camptwright/capstone-pcb-design/extra/extra/Screenshot 2026-03-03 145133.png

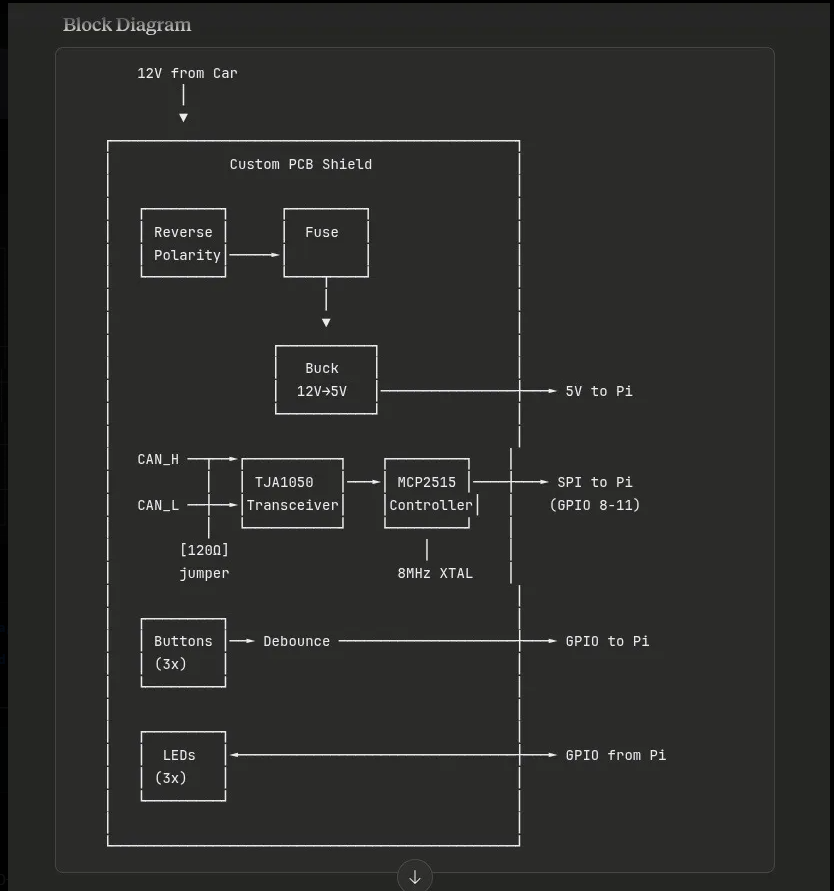
extra/extra/Screenshot 2026-03-03 145133.png
