camptwright/capstone-pcb-design/extra/extra/unnamed (1).png

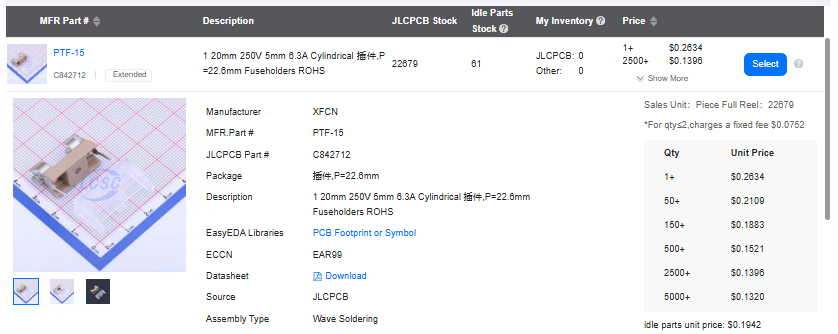
extra/extra/unnamed (1).png
