camptwright/capstone-pcb-design/extra/extra/unnamed (2).png

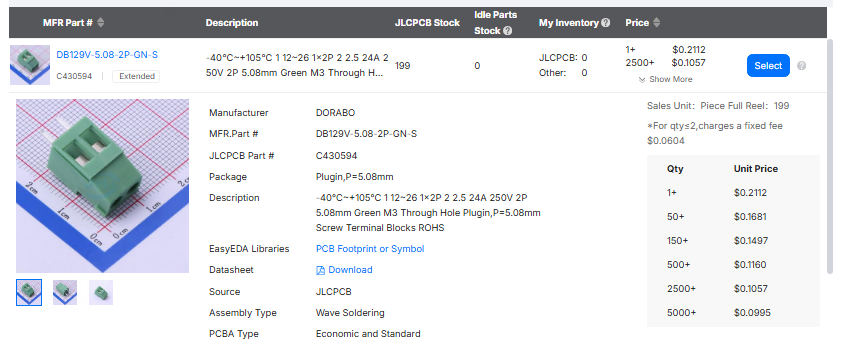
extra/extra/unnamed (2).png
