camptwright/capstone-pcb-design/extra/extra/unnamed (3).png

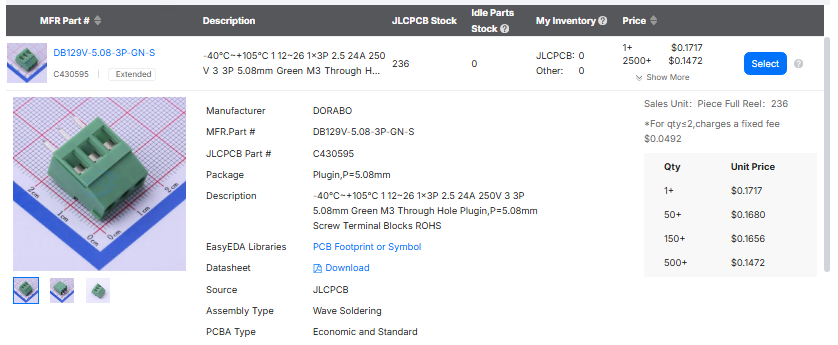
extra/extra/unnamed (3).png
