camptwright/capstone-pcb-design/extra/extra/unnamed.png

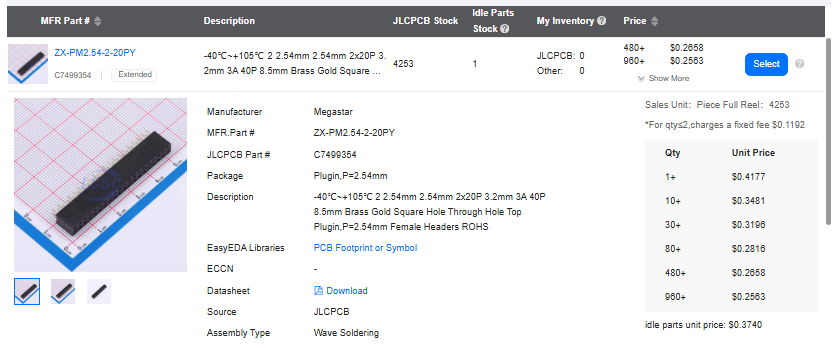
extra/extra/unnamed.png
