camptwright/capstone-pcb-design/extra/extra/T-I4W645599A-1sets-fsae_daughterboard_BOM_PCBWay(2026-03-10).xls

PCBWay Bom Quotation, Product No.:T-I4W645599A
Item # | *Designator | *Qty | *Mfg Part # | Description / Value | *Package/Footprint | *Unit Price(1 set) | *Total | *Delivery Time | *Actual Purchase Mfg Part # | *PCBWay Note | Customer Reply | PCBWay Update
1 | SW1 SW2 SW3 | 3 | TS-06104 | 6mm Tactile Push Button | SW_PUSH_6mm_H5mm |  |  |  |  | [It's out of stock. Please recommend substitutes or you can supply this part to us.] | Please use an equivalent 6 mm × 6 mm through‑hole tactile push button with the same 4‑pin 2.54 mm × 4.5 mm footprint and ~5 mm height as TS‑06104. Preferred: Schurter 1301.9301 (DigiKey 486‑3457‑ND) or any fully compatible 6×6×5 mm THT tact switch. If no exact substitute is available, please leave SW1, SW2, SW3 unmounted (DNP) and I will install them myself.
2 | LED3 | 1 | LED 5mm Green | Green LED 5mm | LED_D5.0mm |  |  |  |  | Please provide exact part number or component URL | Please use Kingbright WP7113SGD – Green 5 mm diffused LED (DigiKey 754‑1735‑ND). Datasheet / URL: https://www.kingbrightusa.com/images/catalog/spec/WP7113SGD.pdf
3 | LED4 | 1 | LED 5mm Blue | Blue LED 5mm | LED_D5.0mm |  |  |  |  | Please provide exact part number or component URL | Please use Everlight EALP05RDGBA0(DGK) – Blue 5 mm LED (DigiKey 1080‑EALP05RDGBA0(DGK)‑ND)
4 | LED5 | 1 | LED 5mm Red | Red LED 5mm | LED_D5.0mm |  |  |  |  | Please provide exact part number or component URL | Please use Kingbright WP7113SRD/J4 – Red 5 mm diffused LED (DigiKey 754‑2139‑ND). Datasheet / URL: https://www.kingbrightusa.com/images/catalog/spec/WP7113SRD-J4.pdf
5 | R5 R6 R7 | 3 | RC0805JR-07330RL | 330R 0805 | R_0805_2012Metric | $0.113 | $0.339
6 | R8 R9 R10 | 3 | RC0805JR-0710KL | 10K 0805 | R_0805_2012Metric | $0.113 | $0.339
7 | C12 C13 C14 | 3 | CL21B104KBCNNNC | 100nF 16V X7R 0805 | C_0805_2012Metric | $0.193 | $0.579 |  |  | The correct voltage for the listed Part Number [CL21B104KBCNNNC] is indeed [50V], not [16V].Please confirm. | Confirmed: 50V is acceptable
8 | J6 | 1 | Molex 43045-0812 | Molex Micro-Fit 3.0 2x4 | Molex_Micro-Fit_3.0_43045-0812_2x04_P3.00mm_Vertical | $0.965 | $0.965 |  | 43045-0812
 |  |  |  |  |  | Component Cost | $2.22
 |  |  |  |  |  | Assembly Cost | $88.00
 |  |  |  |  |  | PCB Cost | $5.00
 |  |  |  |  |  | V0 Member 0% off | $0.00
 |  |  |  |  |  | All Total 1 Sets | $95.22
客户相同型号的位号分开了，这次给客户合并了，麻烦客户下次提供相同型号的位号放在一起的bom
