camptwright/capstone-pcb-design/extra/extra/updated  quotation-T-6P2W645599A-1sets-fsae_pcb_BOM_PCBWay(2026-03-11).xls

PCBWay Bom Quotation, Product No.:T-6P2W645599A
Item # | *Designator | *Qty | Manufacturer | *Mfg Part # | Description / Value | *Package/Footprint | *Unit Price(1 set) | *Total | *Delivery Time | *Actual Purchase Mfg Part # | *PCBWay Note | Customer Reply | PCBWay Update
1 | R_FB1 | 1 |  | RC0805FR-07100KL | 100K 1% 0805 | R_0805_2012Metric | $0.079 | $0.079
2 | R_FB2 | 1 |  | RC0805FR-0719K1L | 19.1K 1% 0805 | R_0805_2012Metric | $0.344 | $0.344 | 7-10 Workdays
3 | R1 R2 | 2 |  | RC0805JR-07330RL | 330R 0805 | R_0805_2012Metric | $0.162 | $0.324
4 | R3 | 1 |  | RC0805JR-07120RL | 120R 0805 | R_0805_2012Metric | $0.309 | $0.309
5 | R4 | 1 |  | RC0805JR-0710KL | 10K 0805 | R_0805_2012Metric | $0.309 | $0.309
6 | C1 C2 | 2 |  | 0805CG220J500NT | 22pF 50V C0G 0805 | C_0805_2012Metric | $0.277 | $0.554
7 | C3 C4 C5 C6 C9 C10 C11 C12 | 8 |  | CL21B104KBCNNNC | 100nF 16V X7R 0805 | C_0805_2012Metric | $0.088 | $0.704 |  |  | CL21B104KBCNNNC 50V
8 | C13 C14 | 2 |  | CL21A106KAYNNNE | 10uF 16V X5R 0805 | C_0805_2012Metric | $0.578 | $1.156 |  |  | CL21A106KAYNNNE 25V
9 | C21 | 1 |  | CL21B103KBANNNC | 10nF 50V X7R 0805 | C_0805_2012Metric | $0.529 | $0.529
10 | C7 | 1 |  | CL32A226MAJNNNE | 22uF 25V X5R 1210 | C_1210_3225Metric | $3.881 | $3.881
11 | C8 | 1 |  | CL32A226MOJNNNE | 22uF 10V X5R 1210 | C_1210_3225Metric | $3.780 | $3.780 |  |  | CL32A226MOJNNNE 16V
12 | U1 | 1 |  | MCP2515-I/SO | MCP2515-I/SO | SOIC-18W_7.5x11.6mm_P1.27mm | $1.912 | $1.912
13 | U2 | 1 |  | SN65HVD230DR | SN65HVD230DR | SOIC-8_3.9x4.9mm_P1.27mm | $1.260 | $1.260 |  |  | SN65HVD230DR brand：TI，package：SOIC-8
14 | U3 | 1 |  | MP1584EN-LF-Z | MP1584EN-LF-Z | SOIC-8-1EP_3.9x4.9mm_P1.27mm_EP2.29x3mm | $0.769 | $0.769
15 | D1 D2 | 2 |  | SS34 | SS34 Schottky SMA | D_SMA | $0.055 | $0.110 |  |  | SS34 brand：BLUE ROCKET，package：SMA
16 | L1 | 1 | Bourns | SWPA3225S330MT | 33uH 3A 1210 | L_1210_3225Metric | $1.922 | $1.922 |  | SRR1260-330M
17 | Y1 | 1 | Abracon | HC49-4H 8MHz 20pF | 8MHz HC49/U Crystal | Crystal_HC49-4H_Vertical | $0.503 | $0.503 |  | ABL-8.000MHZ-B2
18 | LED1 | 1 | Kingbright | LED 3mm Green | Green LED 3mm | LED_D3.0mm | $1.845 | $1.845 | 7-10 Workdays | WP710A10LZGCK
19 | LED2 | 1 | Kingbright | LED 3mm Blue | Blue LED 3mm | LED_D3.0mm | $1.627 | $1.627 | 7-10 Workdays | WP710A10LVBC/D
20 | F1 | 1 |  | Littelfuse 0215003.MXP + 01110008Z | 3A 5x20mm Fuse + Holder | Fuseholder_Clip-5x20mm_Littelfuse_111_Inline_P20.00x5.00mm_D1.05mm_Horizontal |  |  |  | "Littelfuse 01000056Z"+ "Littelfuse 0235003.HXP | 0235003.HXP is out of stock ,
21 | J1 | 1 |  | 2x20 2.54mm Male Pin Header | 2x20 Pin Header 2.54mm | Pin_Header_Straight_2x20 | $1.060 | $1.060 |  | ZX-PM2.54-2-20PY
22 | J2 | 1 |  | Molex 43045-0812 | Molex Micro-Fit 3.0 2x4 | Molex_Micro-Fit_3.0_43045-0812_2x04_P3.00mm_Vertical | $0.965 | $0.965 |  | 43045-0812
23 | J3 | 1 |  | 1x06 2.54mm Male Pin Header | 1x06 Pin Header 2.54mm | PinHeader_1x06_P2.54mm_Vertical | $1.092 | $1.092 | 7-10 Workdays | PREC006SAAN-RC
24 | J4 | 1 |  | Phoenix 1729128 | Phoenix MKDS 1.5/3-5.08 Screw Terminal | TerminalBlock_Phoenix_MKDS-1 5-3-5.08_1x03_P5.08mm_Horizontal | $1.319 | $1.319 |  | 1729128
25 | J5 | 1 |  | Phoenix 1729017 | Phoenix MKDS 1.5/2-5.08 Screw Terminal | TerminalBlock_Phoenix_MKDS-1 5-3-5.08_1x03_P5.08mm_Horizontal |  |  |  | 1729017 | We can't find any 1729017 ，Please provide exact part number or component URL
26 | J6 | 1 |  | 1x02 2.54mm Male Pin Header | 1x02 Pin Header 2.54mm | PinHeader_1x02_P2.54mm_Vertical | $0.907 | $0.907 | 7-10 Workdays | PREC002SAAN-RC
27 | J7 | 1 |  | 1x04 2.54mm Male Pin Header | 1x04 Pin Header 2.54mm | PinHeader_1x04_P2.54mm_Vertical | $1.002 | $1.002 | 7-10 Workdays | PREC004SAAN-RC
28 | JP1 | 1 |  | 1x02 2.54mm Male Pin Header | 1x02 Pin Header 2.54mm (CAN Term Jumper) | PinHeader_1x02_P2.54mm_Vertical | $0.907 | $0.907 | 7-10 Workdays | PREC002SAAN-RC
 |  |  |  |  |  |  | Component Cost | $29.17
 |  |  |  |  |  |  | Assembly Cost | $29.00
 |  |  |  |  |  |  | PCB Cost | $5.00
 |  |  |  |  |  |  | V0 Member 0% off | $0.00
 |  |  |  |  |  |  | All Total 1 Sets | $63.17
