camptwright/capstone-pcb-design/extra/extra/updated quotation-T-I4W645599A-1sets-fsae_daughterboard_BOM_PCBWay(2026-03-11).xls

PCBWay Bom Quotation, Product No.:T-I4W645599A
Item # | *Designator | *Qty | Manufacturer | *Mfg Part # | Description / Value | *Package/Footprint | *Unit Price(1 set) | *Total | *Delivery Time | *Actual Purchase Mfg Part # | *PCBWay Note | Customer Reply | PCBWay Update
1 | SW1 SW2 SW3 | 3 | Schurter | TS-06104 | 6mm Tactile Push Button | SW_PUSH_6mm_H5mm | $1.250 | $3.750 | 7-10 Workdays | 1301.9301
2 | LED3 | 1 |  | LED 5mm Green | Green LED 5mm | LED_D5.0mm | $0.782 | $0.782 | 7-10 Workdays | WP7113SGD
3 | LED4 | 1 |  | LED 5mm Blue | Blue LED 5mm | LED_D5.0mm | $1.126 | $1.126 | 7-10 Workdays | EALP05RDGBA0(DGK)
4 | LED5 | 1 |  | LED 5mm Red | Red LED 5mm | LED_D5.0mm | $2.063 | $2.063 | 7-10 Workdays | WP7113SRD/J4
5 | R5 R6 R7 | 3 |  | RC0805JR-07330RL | 330R 0805 | R_0805_2012Metric | $0.113 | $0.339
6 | R8 R9 R10 | 3 |  | RC0805JR-0710KL | 10K 0805 | R_0805_2012Metric | $0.113 | $0.339
7 | C12 C13 C14 | 3 |  | CL21B104KBCNNNC | 100nF 16V X7R 0805 | C_0805_2012Metric | $0.193 | $0.579 |  |  | CL21B104KBCNNNC 50V
8 | J6 | 1 |  | Molex 43045-0812 | Molex Micro-Fit 3.0 2x4 | Molex_Micro-Fit_3.0_43045-0812_2x04_P3.00mm_Vertical | $0.965 | $0.965 |  | 43045-0812
 |  |  |  |  |  |  | Component Cost | $9.94
 |  |  |  |  |  |  | Assembly Cost | $88.00
 |  |  |  |  |  |  | PCB Cost | $5.00
 |  |  |  |  |  |  | V0 Member 0% off | $0.00
 |  |  |  |  |  |  | All Total 1 Sets | $102.94
客户相同型号的位号分开了，这次给客户合并了，麻烦客户下次提供相同型号的位号放在一起的bom
