camptwright/capstone-pcb-design/(list of files, drawings)

Other design files:
extra/fsae_daughterboard/fsae_daughterboard.dsn
extra/fsae_pcb/fsae_pcb.dsn
