camptwright/capstone-pcb-design/extra/fsae_pcb/fsae_pcb.kicad_pcb

## KiCad design extra/fsae_pcb/fsae_pcb.kicad_pcb (2026-03-13)

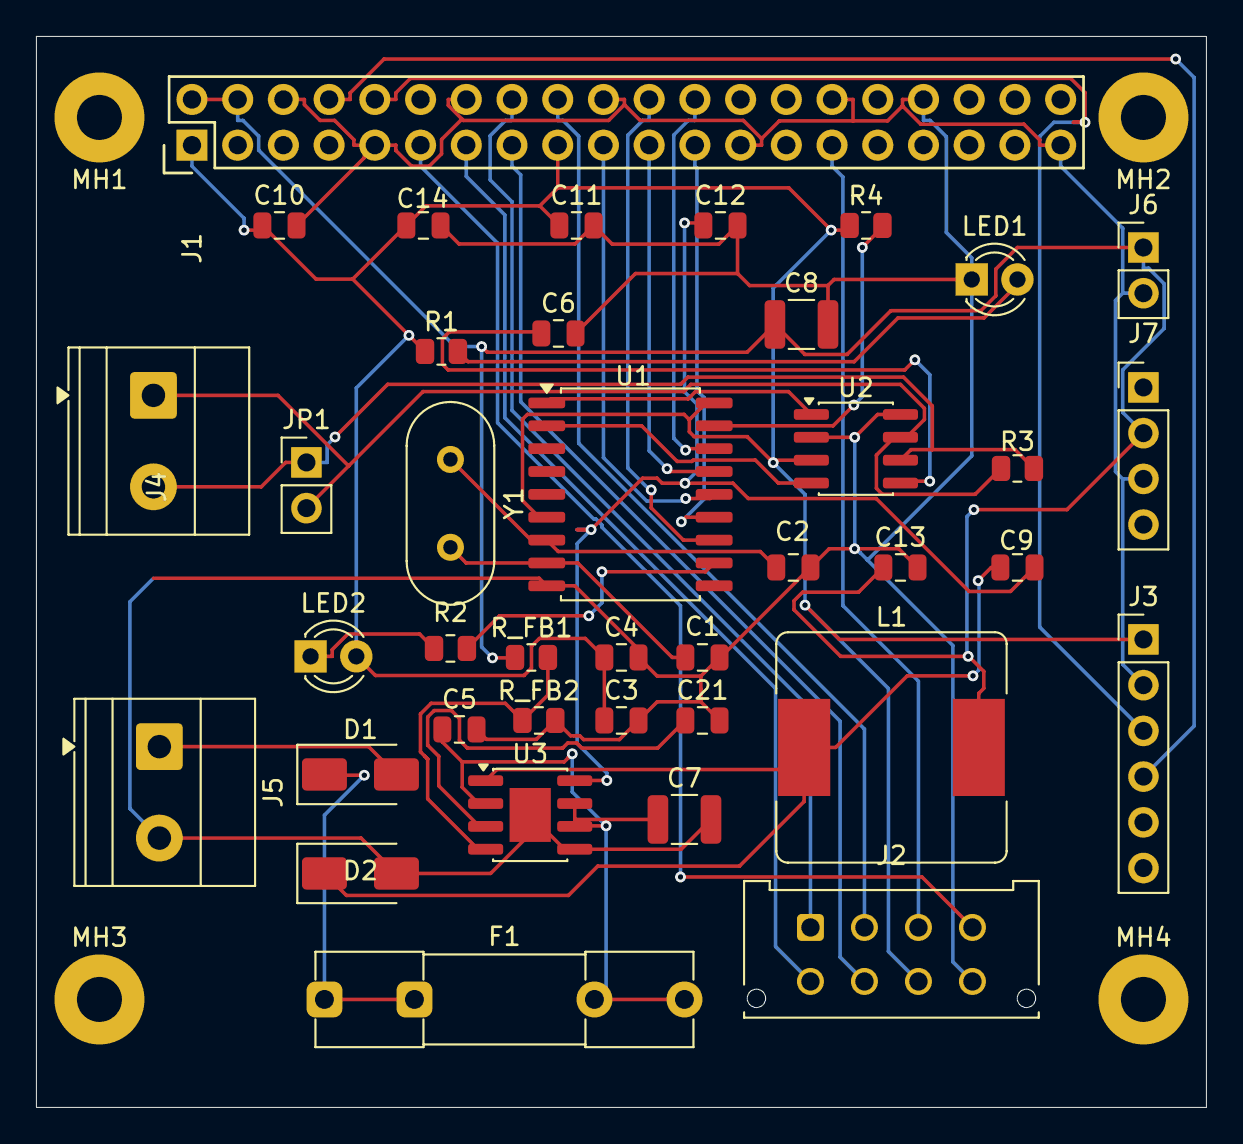
[picture p6: board fsae_pcb.kicad_pcb from above]

Board: 2 copper layers, 65.0 x 59.5 mm, 43 parts (0 on the bottom side), 34 nets.

Parts:
C1, C5, C6, C9, C21: C; C_0805_2012Metric
C2: 22pF; C_0805_2012Metric
C3, C4, C10, C11, C12: 110nF; C_0805_2012Metric
C7, C8: C; C_1210_3225Metric
C13, C14: 10microF; C_0805_2012Metric
D1, D2: D_Schottky; D_SMA
F1: Fuse; Fuseholder_Clip-5x20mm_Littelfuse_111_Inline_P20.00x5.00mm_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
J1: Conn_02x20_Odd_Even; Pin_Header_Straight_2x20
J2: Conn_02x04_Odd_Even; Molex_Micro-Fit_3.0_43045-0812_2x04_P3.00mm_Vertical
J3: Conn_01x06; PinHeader_1x06_P2.54mm_Vertical
J4, J5: Screw_Terminal_01x02; TerminalBlock_Phoenix_MKDS-1,5-2-5.08_1x02_P5.08mm_Horizont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
J6: Conn_01x02; PinHeader_1x02_P2.54mm_Vertical
J7: Conn_01x04; PinHeader_1x04_P2.54mm_Vertical
JP1: Conn_01x02; PinHeader_1x02_P2.54mm_Vertical
L1: L; L_Bourns_SRR1260
LED1, LED2: LED; LED_D3.0mm
MH1, MH2, MH3, MH4: MountingHole_2.5mm_Pad
R1, R2: 330; R_0805_2012Metric
R3: 120; R_0805_2012Metric
R4: 10k; R_0805_2012Metric
R_FB1, R_FB2: R; R_0805_2012Metric
U1: MCP2515-xSO; SOIC-18W_7.5x11.6mm_P1.27mm
U2: SN65HVD230; SOIC-8_3.9x4.9mm_P1.27mm
U3: MP1584EN-LF-Z; SOIC-8-1EP_3.9x4.9mm_P1.27mm_EP2.29x3mm
Y1: Crystal; Crystal_HC49-4H_Vertical

Connections:
+3V3: C3.1, C4.1, C10.1, C11.1, C14.1, J1.1, J1.17, J2.7, J3.1, LED2.2 (A), R1.1, R4.1, U1.6 (~TX2RTS), U1.18 (VDD), U2.3 (VCC)
+5V: C8.1, C13.1, J1.2, J1.4, J6.1, J7.2, L1.2, R_FB1.1
+12V: D1.2 (A), J5.1
/BTN1: J1.11, J2.4
/BTN2: J1.13, J2.5
/BTN3: J1.15, J2.6
/GPS_RX: J1.8, J3.4
/GPS_TX: J1.10, J3.3
/LED_DB1: J1.16, J2.1
/LED_DB2: J1.18, J2.2
/LED_DB3: J1.29, J2.3
/MCP_INT: J1.22, U1.12 (~INT)
/SPI_CE0: J1.24, U1.16 (~CS)
/SPI_MISO: J1.21, U1.15 (SO)
/SPI_MOSI: J1.19, U1.14 (SI)
/SPI_SCK: J1.23, U1.13 (SCK)
GND: C1.2, C2.2, C3.2, C4.2, C5.2, C6.2, C7.2, C8.2, C10.2, C11.2, C12.2, C13.2, C14.2, C21.2, D2.2 (A), J1.6, J1.9, J1.14, J1.20, J1.25, J1.30, J1.34, J1.39, J2.8, J3.2, J5.2, J6.2, J7.3, LED1.1 (K), R_FB2.2, U1.9 (VSS), U2.2 (GND), U2.8 (Rs), U3.5 (GND), U3.9 (EPAD)
unnamed: D1.1 (K), F1.1
unnamed: C9.1, D2.1 (K), L1.1, U3.1 (SW)
unnamed: J4.1, JP1.2, R3.1, U2.7 (CANH)
unnamed: J4.2, JP1.1, R3.2, U2.6 (CANL)
unnamed: LED1.2 (A), R1.2
unnamed: LED2.1 (K), R2.1
unnamed: C1.1, U1.8 (OSC1), Y1.2
unnamed: C2.1, U1.7 (OSC2), Y1.1
unnamed: U1.2 (RXCAN), U2.4 (R)
unnamed: U1.1 (TXCAN), U2.1 (D)
unnamed: R4.2, U1.17 (~RESET)
unnamed: R2.2, U1.11 (~RX0BF)
unnamed: C6.1, U2.5 (Vref)
unnamed: C9.2, C12.1, U3.8 (BST)
unnamed: C21.1, U3.3 (COMP)
unnamed: C5.1, C7.1, F1.2, U3.2 (EN), U3.6 (FREQ), U3.7 (VIN)
unnamed: R_FB1.2, R_FB2.1, U3.4 (FB)
