camptwright/capstone-pcb-design/extra/fsae_daughterboard/fsae_daughterboard.kicad_pcb

## KiCad design extra/fsae_daughterboard/fsae_daughterboard.kicad_pcb (2026-03-10)

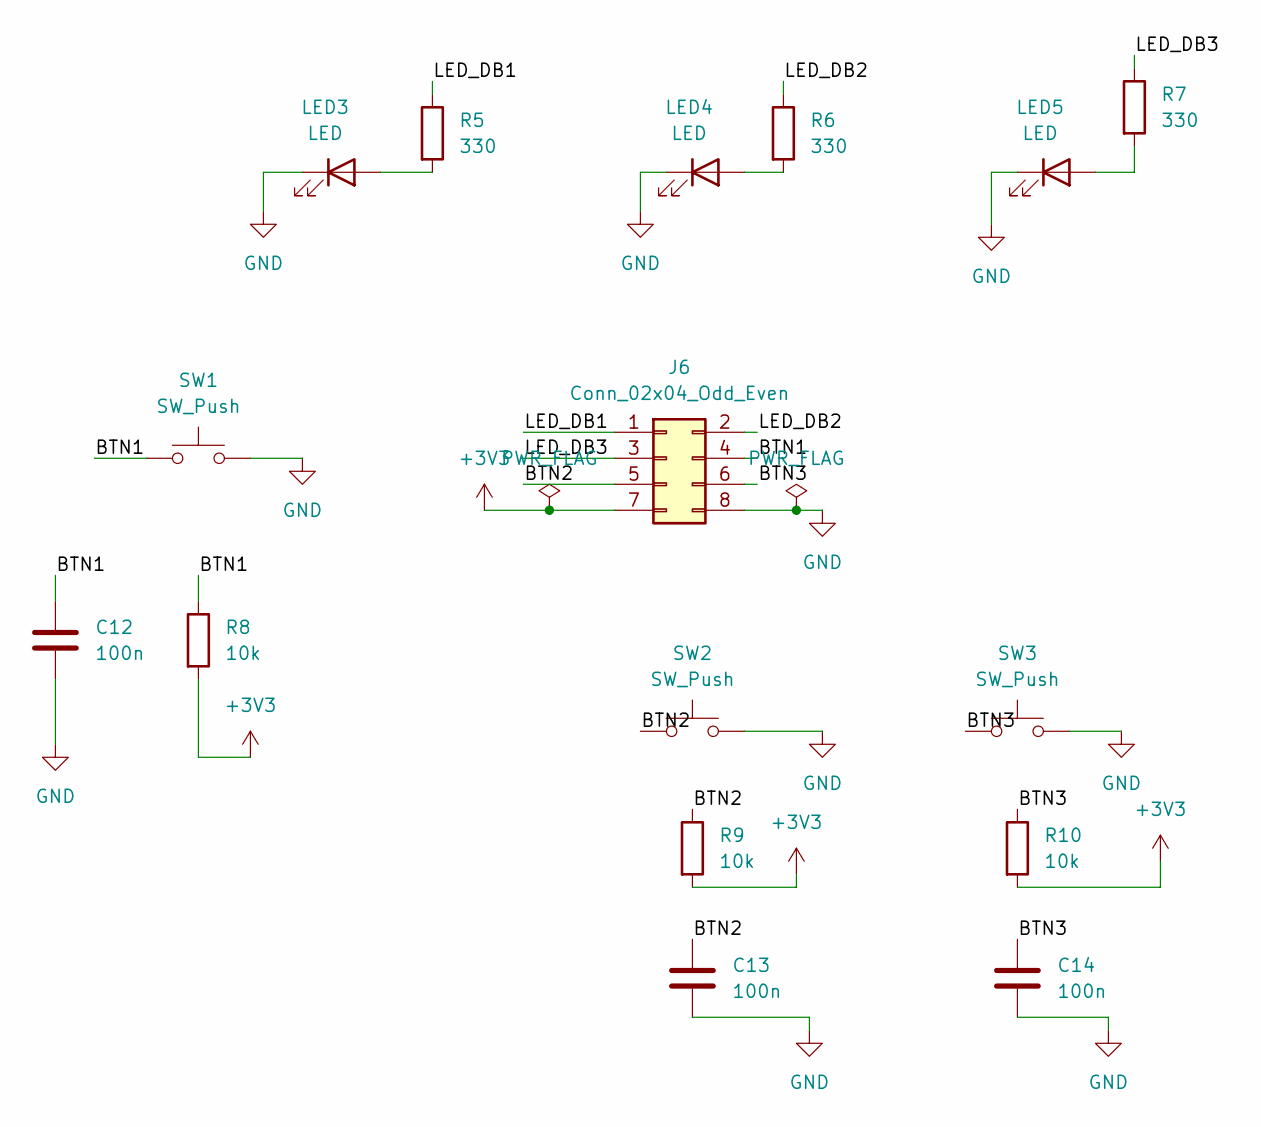
[picture p7: schematic fsae_daughterboard.kicad_sch]

Parts:
C12, C13, C14: 100n; C_0805_2012Metric
J6: Conn_02x04_Odd_Even; Molex_Micro-Fit_3.0_43045-0812_2x04_P3.00mm_Vertical
LED3, LED4, LED5: LED; LED_D5.0mm
R5, R6, R7: 330; R_0805_2012Metric
R8, R9, R10: 10k; R_0805_2012Metric
SW1, SW2, SW3: SW_Push; SW_PUSH_6mm_H5mm

Connections:
+3V3: J6.7, R8.2, R9.2, R10.2
/BTN1: C12.1, J6.4, R8.1, SW1.1
/BTN2: C13.1, J6.5, R9.1, SW2.1
/BTN3: C14.1, J6.6, R10.1, SW3.1
/LED_DB1: J6.1, R5.1
/LED_DB2: J6.2, R6.1
/LED_DB3: J6.3, R7.1
GND: C12.2, C13.2, C14.2, J6.8, LED3.1 (K), LED4.1 (K), LED5.1 (K), SW1.2, SW2.2, SW3.2
unnamed: LED3.2 (A), R5.2
unnamed: LED4.2 (A), R6.2
unnamed: LED5.2 (A), R7.2

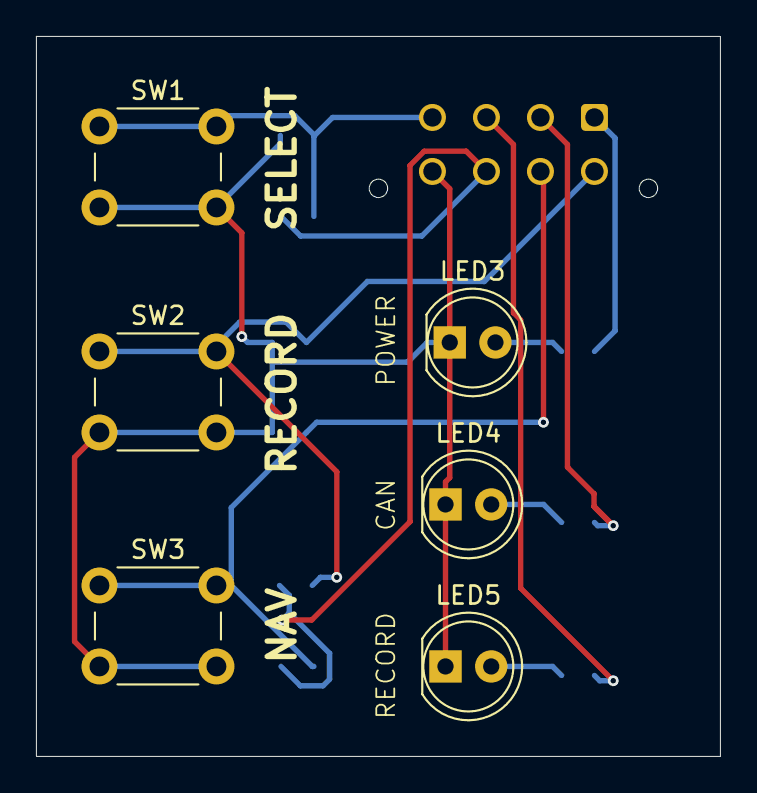
[picture p8: board fsae_daughterboard.kicad_pcb from above]

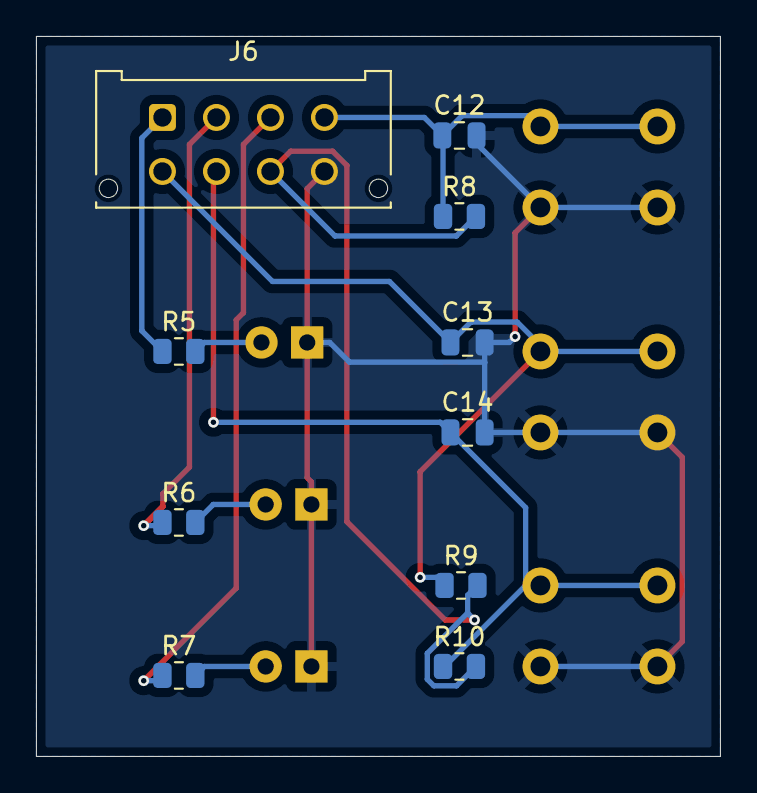
[picture p9: board fsae_daughterboard.kicad_pcb from below]

Board: 2 copper layers, 38.0 x 40.0 mm, 16 parts (10 on the bottom side), 11 nets.
