camptwright/capstone-pcb-design/(commit log)

2026-03-05 new main pcb design
    [fsae_pcb.kicad_sch]
2026-03-10 finished product
    [S10_POWER_IN.kicad_sch, S20_CAN.kicad_sch, S30_IO.kicad_sch, S30_Pi_Header.kicad_sch, S40_Molex_IO.kicad_sch, S40_Pi_Header.kicad_sch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]
2026-03-13 final pcb desgin
    [DigiKey_BOM.csv, DigiKey_Order_x5.csv, Sample-BOM_JLCSMT.xlsx, Sample_BOM_PCBWay.xlsx, T-6P2W645599A-1sets-fsae_pcb_BOM_PCBWay(2026-03-10) (1).xls, T-6P2W645599A-1sets-fsae_pcb_BOM_PCBWay(2026-03-10).xls, T-I4W645599A-1sets-fsae_daughterboard_BOM_PCBWay(2026-03-10).xls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]
